polpo/imagescribbler/lt-option-clone.kicad_sch

## KiCad design lt-option-clone.kicad_sch (2025-03-09)

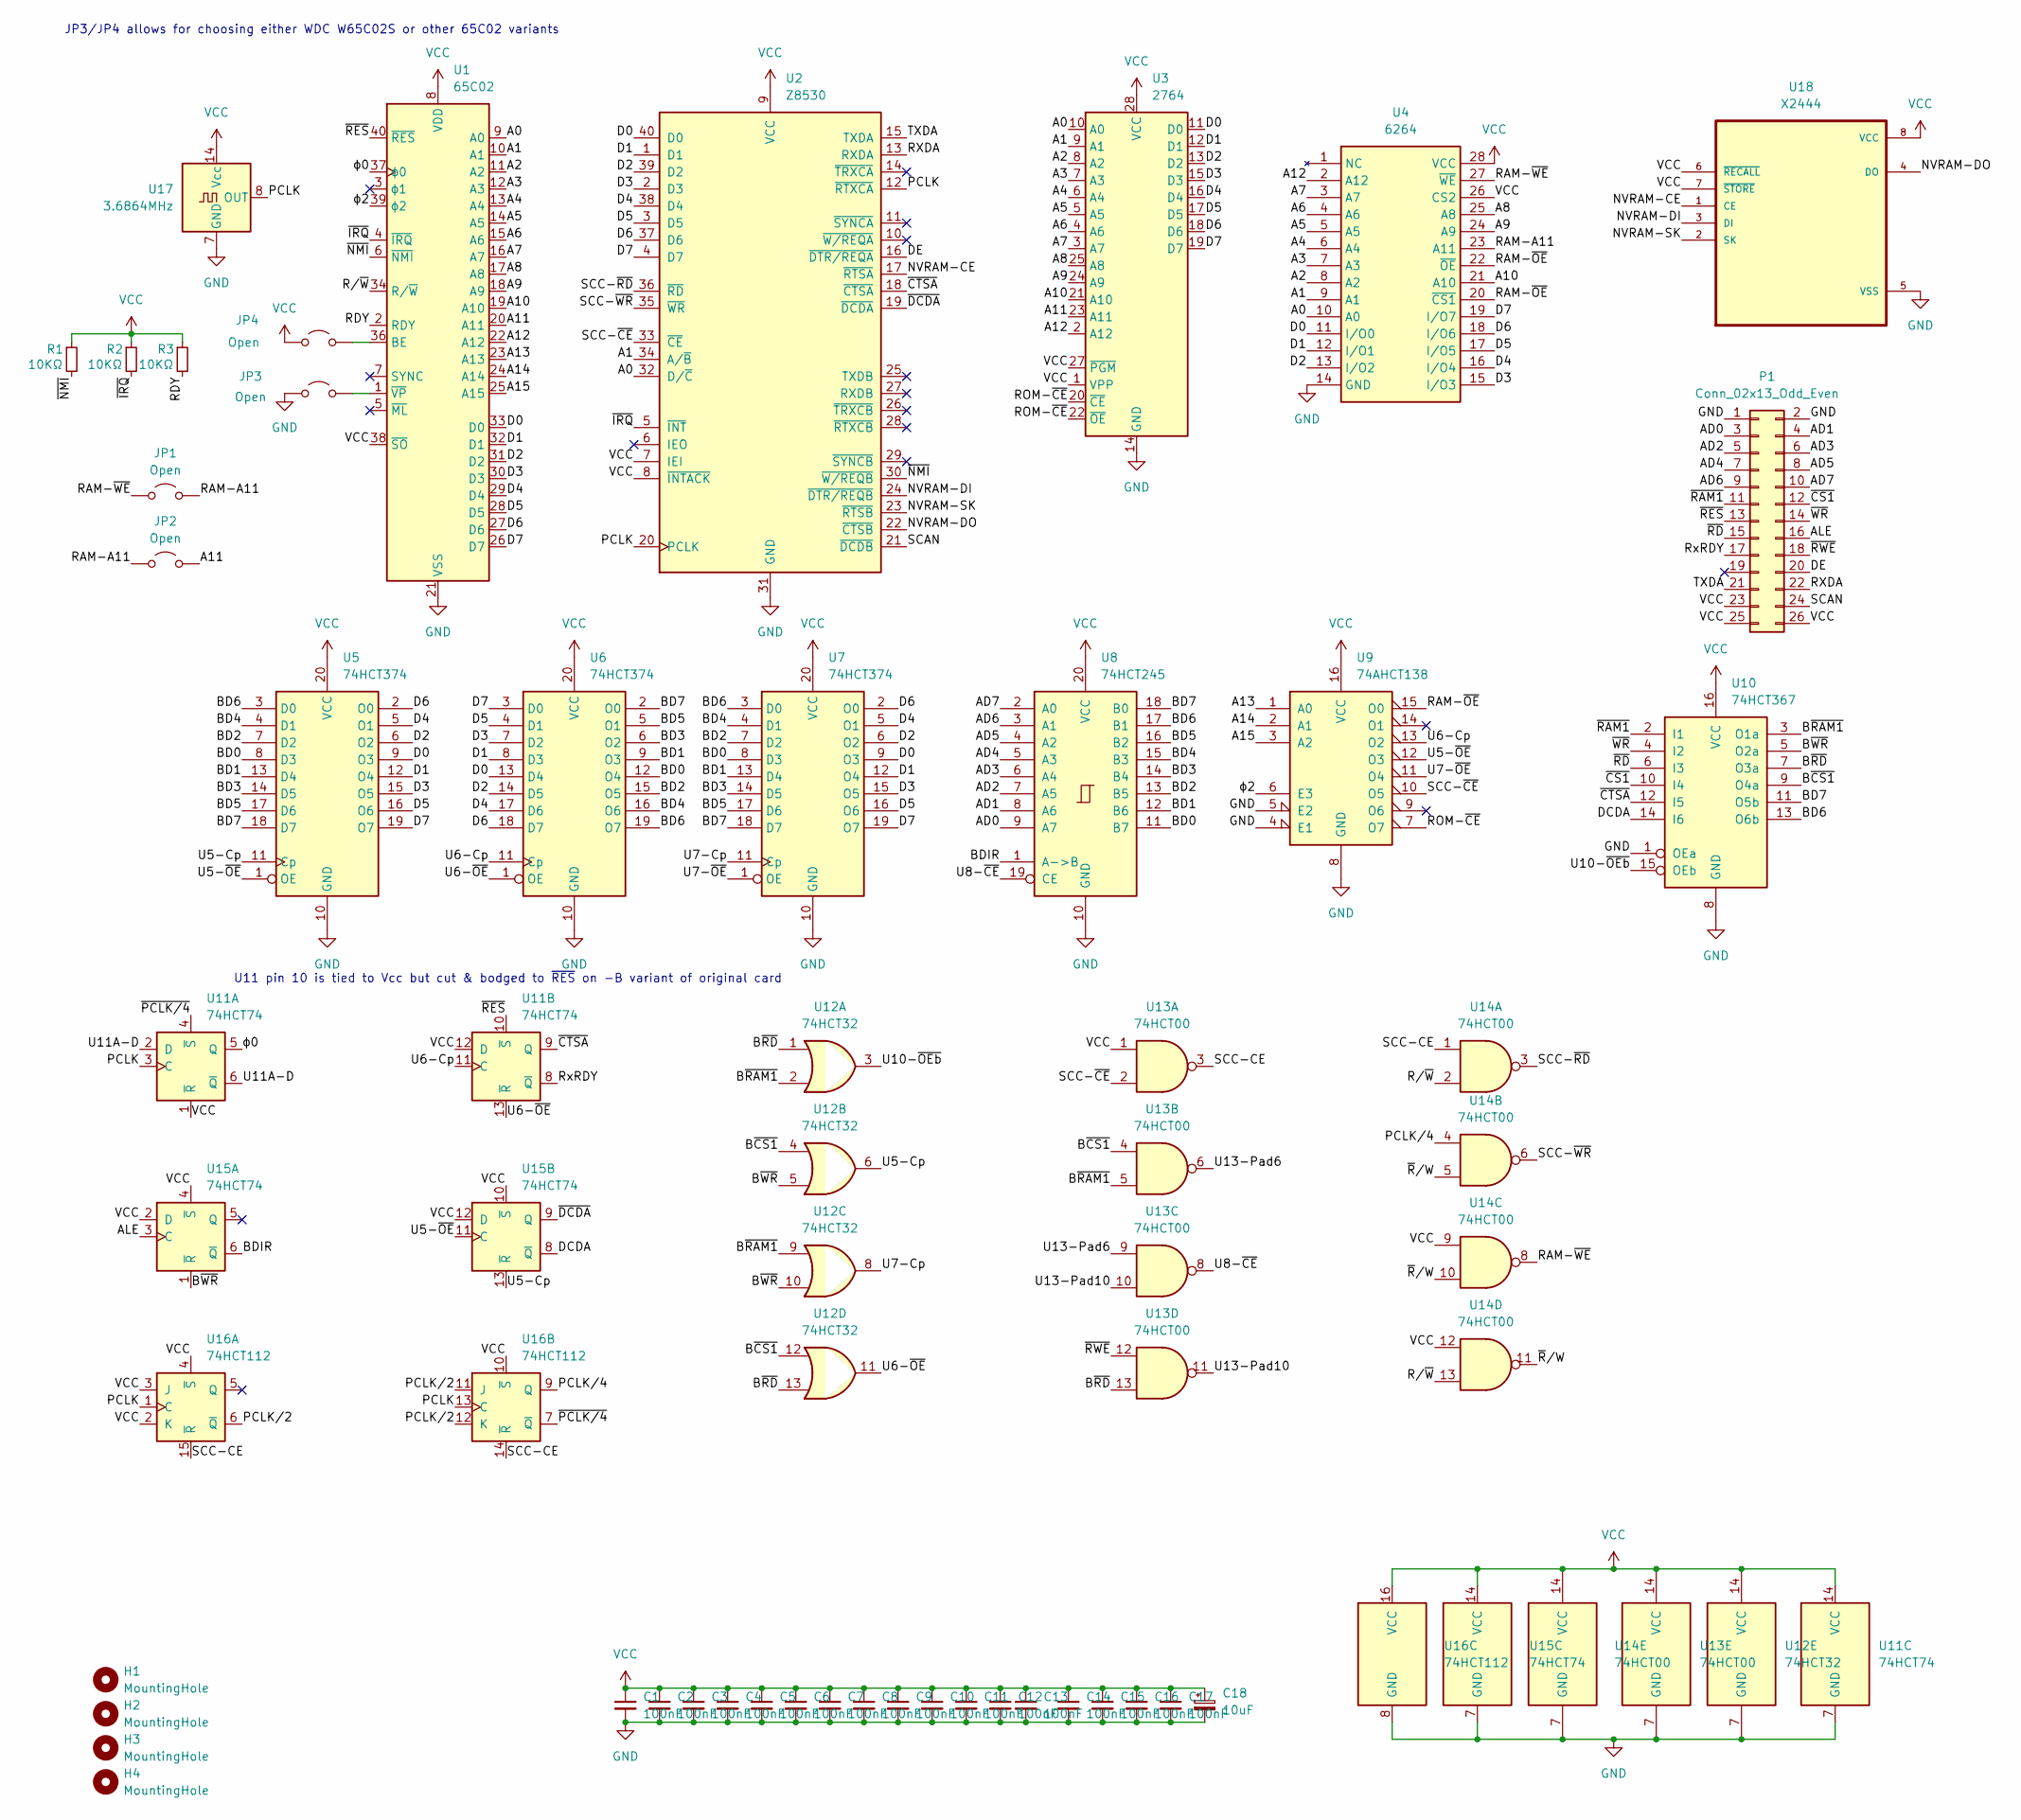
[picture p1: schematic lt-option-clone.kicad_sch]

Parts:
C1, C2, C3, C4, C5, C6, C7, C8, C9, C10, C11, C12, C13, C14, C15, C16, C17: 100nF; C_Disc_D4.3mm_W1.9mm_P5.00mm; Mouser Part Number 810-FG28X7R1H104KNT6; DigiKey Part Number 445-173588-1-ND
C18: 10uF; CP_Radial_D6.3mm_P2.50mm; Mouser Part Number 667-ECE-A1CKS100I; DigiKey Part Number 10-ECE-A1CKS100ICT-ND
H1, H2, H3, H4: MountingHole; Mouser Part Number 855-R6413-00; DigiKey Part Number 952-3469-ND
JP1, JP2, JP3, JP4: Open; Jumper_1x02_P2.54mm_Vertical-SolderBridge
P1: Conn_02x13_Odd_Even; PinSocket_2x13_P2.54mm_Vertical; Mouser Part Number 798-HIF3FB26DA254D71; DigiKey Part Number H123833-ND
R1, R2, R3: 10KΩ; R_Axial_DIN0207_L6.3mm_D2.5mm_P7.62mm_Horizontal; Manufacturer Part Number CFR-12JB-52-10K; DigiKey Part Number 10KEBK-ND
U1: 65C02; DIP-40_W15.24mm; Mouser Part Number 955-W65C02S6TPG-14
U2: Z8530; DIP-40_W15.24mm
U3: 2764; DIP-28_W15.24mm; Mouser Part Number 556-AT28C64B15PU; DigiKey Part Number AT28C64B-15PU-ND
U4: 6264; DIP-28_WW7.62mm-15.24mm; Mouser Part Number 913-AS6C6264-55PCN
U5, U6, U7: 74HCT374; DIP-20_W7.62mm; Mouser Part Number 595-SN74HCT374N; DigiKey Part Number 296-1617-5-ND
U8: 74HCT245; DIP-20_W7.62mm; Mouser Part Number 595-SN74HCT245N; DigiKey Part Number 296-1612-5-ND
U9: 74AHCT138; DIP-16_W7.62mm; Mouser Part Number 595-SN74AHCT138N; DigiKey Part Number 296-4666-5-ND
U10: 74HCT367; DIP-16_W7.62mm; Mouser Part Number 595-CD74HCT367E; DigiKey Part Number 296-2113-5-ND
U11, U15: 74HCT74; DIP-14_W7.62mm; Mouser Part Number 595-SN74HC74N; DigiKey Part Number 296-1625-5-ND
U12: 74HCT32; DIP-14_W7.62mm; Mouser Part Number 595-CD74HCT112E; DigiKey Part Number 296-2112-5-ND
U13: 74HCT00; DIP-14_W7.62mm; Mouser Part Number 595-SN74HCT00N; DigiKey Part Number 296-2081-5-ND
U14: 74HCT00; DIP-14_W7.62mm; Manufacturer Part Number CD74HCT00E; Mouser Part Number 595-SN74HCT00N
U16: 74HCT112; DIP-16_W7.62mm; Mouser Part Number 595-CD74HCT112E; DigiKey Part Number 296-9248-5-ND
U17: 3.6864MHz; Oscillator_DIP-8-14; Mouser Part Number 774-MXO45-3C-3.6; DigiKey Part Number X941-ND
U18: X2444; DIP-8_W7.62mm; DigiKey Part Number CAT24C44LI-ND

Connections:
A0: U1.9 (A0), U2.32 (D/~C), U3.10 (A0), U4.10 (A0)
A1: U1.10 (A1), U2.34 (A/~B), U3.9 (A1), U4.9 (A1)
A2: U1.11 (A2), U3.8 (A2), U4.8 (A2)
A3: U1.12 (A3), U3.7 (A3), U4.7 (A3)
A4: U1.13 (A4), U3.6 (A4), U4.6 (A4)
A5: U1.14 (A5), U3.5 (A5), U4.5 (A5)
A6: U1.15 (A6), U3.4 (A6), U4.4 (A6)
A7: U1.16 (A7), U3.3 (A7), U4.3 (A7)
A8: U1.17 (A8), U3.25 (A8), U4.25 (A8)
A9: U1.18 (A9), U3.24 (A9), U4.24 (A9)
A10: U1.19 (A10), U3.21 (A10), U4.21 (A10)
A11: JP2.2 (B), U1.20 (A11), U3.23 (A11)
A12: U1.22 (A12), U3.2 (A12), U4.2 (A12)
A13: U1.23 (A13), U9.1 (A0)
A14: U1.24 (A14), U9.2 (A1)
A15: U1.25 (A15), U9.3 (A2)
AD0: P1.3, U8.9 (A7)
AD1: P1.4, U8.8 (A6)
AD2: P1.5, U8.7 (A5)
AD3: P1.6, U8.6 (A4)
AD4: P1.7, U8.5 (A3)
AD5: P1.8, U8.4 (A2)
AD6: P1.9, U8.3 (A1)
AD7: P1.10, U8.2 (A0)
ALE: P1.16, U15.3 (C)
BD0: U5.8 (D3), U6.12 (O4), U7.8 (D3), U8.11 (B7)
BD1: U5.13 (D4), U6.9 (O3), U7.13 (D4), U8.12 (B6)
BD2: U5.7 (D2), U6.15 (O5), U7.7 (D2), U8.13 (B5)
BD3: U5.14 (D5), U6.6 (O2), U7.14 (D5), U8.14 (B4)
BD4: U5.4 (D1), U6.16 (O6), U7.4 (D1), U8.15 (B3)
BD5: U5.17 (D6), U6.5 (O1), U7.17 (D6), U8.16 (B2)
BD6: U5.3 (D0), U6.19 (O7), U7.3 (D0), U8.17 (B1), U10.13 (O6b)
BD7: U5.18 (D7), U6.2 (O0), U7.18 (D7), U8.18 (B0), U10.11 (O5b)
BDIR: U8.1 (A->B), U15.6 (~Q)
B~CS1: U10.9 (O4a), U12.4, U12.12, U13.4
B~RAM1: U10.3 (O1a), U12.2, U12.9, U13.5
B~RD: U10.7 (O3a), U12.1, U12.13, U13.13
B~WR: U10.5 (O2a), U12.5, U12.10, U15.1 (~R)
D0: U1.33 (D0), U2.40 (D0), U3.11 (D0), U4.11 (I/O0), U5.9 (O3), U6.13 (D4), U7.9 (O3)
D1: U1.32 (D1), U2.1 (D1), U3.12 (D1), U4.12 (I/O1), U5.12 (O4), U6.8 (D3), U7.12 (O4)
D2: U1.31 (D2), U2.39 (D2), U3.13 (D2), U4.13 (I/O2), U5.6 (O2), U6.14 (D5), U7.6 (O2)
D3: U1.30 (D3), U2.2 (D3), U3.15 (D3), U4.15 (I/O3), U5.15 (O5), U6.7 (D2), U7.15 (O5)
D4: U1.29 (D4), U2.38 (D4), U3.16 (D4), U4.16 (I/O4), U5.5 (O1), U6.17 (D6), U7.5 (O1)
D5: U1.28 (D5), U2.3 (D5), U3.17 (D5), U4.17 (I/O5), U5.16 (O6), U6.4 (D1), U7.16 (O6)
D6: U1.27 (D6), U2.37 (D6), U3.18 (D6), U4.18 (I/O6), U5.2 (O0), U6.18 (D7), U7.2 (O0)
D7: U1.26 (D7), U2.4 (D7), U3.19 (D7), U4.19 (I/O7), U5.19 (O7), U6.3 (D0), U7.19 (O7)
DCDA: U10.14 (I6), U15.8 (~Q)
DE: P1.20, U2.16 (~DTR/REQA)
GND: C1.2, C2.2, C3.2, C4.2, C5.2, C6.2, C7.2, C8.2, C9.2, C10.2, C11.2, C12.2, C13.2, C14.2, C15.2, C16.2, C17.2, C18.2, JP3.1 (A), P1.1, P1.2, U1.21 (VSS), U2.31 (GND), U3.14 (GND), U4.14 (GND), U5.10 (GND), U6.10 (GND), U7.10 (GND), U8.10 (GND), U9.4 (E1), U9.5 (E2), U9.8 (GND), U10.1 (OEa), U10.8 (GND), U11.7 (GND), U12.7 (GND), U13.7 (GND), U14.7 (GND), U15.7 (GND), U16.8 (GND), U17.7 (GND), U18.5 (VSS)
NVRAM-CE: U2.17 (~RTSA), U18.1 (CE)
NVRAM-DI: U2.24 (~DTR/REQB), U18.3 (DI)
NVRAM-DO: U2.22 (~CTSB), U18.4 (DO)
NVRAM-SK: U2.23 (~RTSB), U18.2 (SK)
unnamed: JP3.2 (B), U1.1 (~VP)
unnamed: JP4.2 (B), U1.36 (BE)
PCLK: U2.12 (~RTXCA), U2.20 (PCLK), U11.3 (C), U16.1 (C), U16.13 (C), U17.8 (OUT)
PCLK/2: U16.6 (~Q), U16.11 (J), U16.12 (K)
PCLK/4: U14.4, U16.9 (Q)
RAM-A11: JP1.2 (B), JP2.1 (A), U4.23 (A11)
RAM-~OE: U4.20 (~CS1), U4.22 (~OE), U9.15 (O0)
RAM-~WE: JP1.1 (A), U4.27 (~WE), U14.8
RDY: R3.2, U1.2 (RDY)
ROM-~CE: U3.20 (~CE), U3.22 (~OE), U9.7 (O7)
RXDA: P1.22, U2.13 (RXDA)
RxRDY: P1.17, U11.8 (~Q)
R/~W: U1.34 (R/~W), U14.2, U14.13
SCAN: P1.24, U2.21 (~DCDB)
SCC-CE: U13.3, U14.1, U16.14 (~R), U16.15 (~R)
SCC-~CE: U2.33 (~CE), U9.10 (O5), U13.2
SCC-~RD: U2.36 (~RD), U14.3
SCC-~WR: U2.35 (~WR), U14.6
TXDA: P1.21, U2.15 (TXDA)
U5-Cp: U5.11 (Cp), U12.6, U15.13 (~R)
U5-~OE: U5.1 (OE), U9.12 (O3), U15.11 (C)
U6-Cp: U6.11 (Cp), U9.13 (O2), U11.11 (C)
U6-~OE: U6.1 (OE), U11.13 (~R), U12.11
U7-Cp: U7.11 (Cp), U12.8
U7-~OE: U7.1 (OE), U9.11 (O4)
U8-~CE: U8.19 (CE), U13.8
U10-~OEb: U10.15 (OEb), U12.3
U11A-D: U11.2 (D), U11.6 (~Q)
U13-Pad6: U13.6, U13.9
U13-Pad10: U13.10, U13.11
VCC: C1.1, C2.1, C3.1, C4.1, C5.1, C6.1, C7.1, C8.1, C9.1, C10.1, C11.1, C12.1, C13.1, C14.1, C15.1, C16.1, C17.1, C18.1, JP4.1 (A), P1.23, P1.25, P1.26, R1.1, R2.1, R3.1, U1.8 (VDD), U1.38 (~SO), U2.7 (IEI), U2.8 (~INTACK), U2.9 (VCC), U3.1 (VPP), U3.27 (~PGM), U3.28 (VCC), U4.26 (CS2), U4.28 (VCC), U5.20 (VCC), U6.20 (VCC), U7.20 (VCC), U8.20 (VCC), U9.16 (VCC), U10.16 (VCC), U11.1 (~R), U11.12 (D), U11.14 (VCC), U12.14 (VCC), U13.1, U13.14 (VCC), U14.9, U14.12, U14.14 (VCC), U15.2 (D), U15.4 (~S), U15.10 (~S), U15.12 (D), U15.14 (VCC), U16.2 (K), U16.3 (J), U16.4 (~S), U16.10 (~S), U16.16 (VCC), U17.14 (Vcc), U18.6 (~RECALL), U18.7 (~STORE), U18.8 (VCC)
~CS1: P1.12, U10.10 (I4)
~CTSA: U2.18 (~CTSA), U10.12 (I5), U11.9 (Q)
~DCDA: U2.19 (~DCDA), U15.9 (Q)
~IRQ: R2.2, U1.4 (~IRQ), U2.5 (~INT)
~NMI: R1.2, U1.6 (~NMI), U2.30 (~W/REQB)
~PCLK/4: U11.4 (~S), U16.7 (~Q)
~RAM1: P1.11, U10.2 (I1)
~RD: P1.15, U10.6 (I3)
~RES: P1.13, U1.40 (~RES), U11.10 (~S)
~RWE: P1.18, U13.12
~R/W: U14.5, U14.10, U14.11
~WR: P1.14, U10.4 (I2)
ϕ0: U1.37 (ϕ0), U11.5 (Q)
ϕ2: U1.39 (ϕ2), U9.6 (E3)

Notes on the sheet:
JP3/JP4 allows for choosing either WDC W65C02S or other 65C02 variants
U11 pin 10 is tied to Vcc but cut & bodged to ~{RES} on -B variant of original card
