polpo/imagescribbler/(commit log)

2025-03-09 Update BOM with resistors
    [bom.csv, lt-option-clone.kicad_sch]
2025-03-09 Add note about ground wire, add standoffs to BOM
    [bom.csv, lt-option-clone.kicad_sch]
